elehobica/CO2monitor/(commit log)

2020-04-28 feat: Supported CSV Dump toggle switch
2020-05-01 feat: Supported Temperature & Humidity capture by DHT22
2020-05-01 feat: Supported COM command and calibration loading/storing from/to flash
2020-05-01 feat: Supported Graph display of Temperature and Humidity
2020-05-09 fix: Fixed the bug that the calibration parameters of RX-9 is not correctly reflected.
    [RX9QR.h, arduino_SeeeduinoXIAO_RX9QR_DHT22.ino]
2020-05-10 feat: Renew CSV file at pSize samples. Added Exception handle in case of COM port is busy
2020-12-20 misc: Removed arduino_SeeeduinoXIAO_RX9QR_DHT22/.gitignore
